jmears63/batgizmo-logger-kicad/horns/exponential-horn-block-2.stl

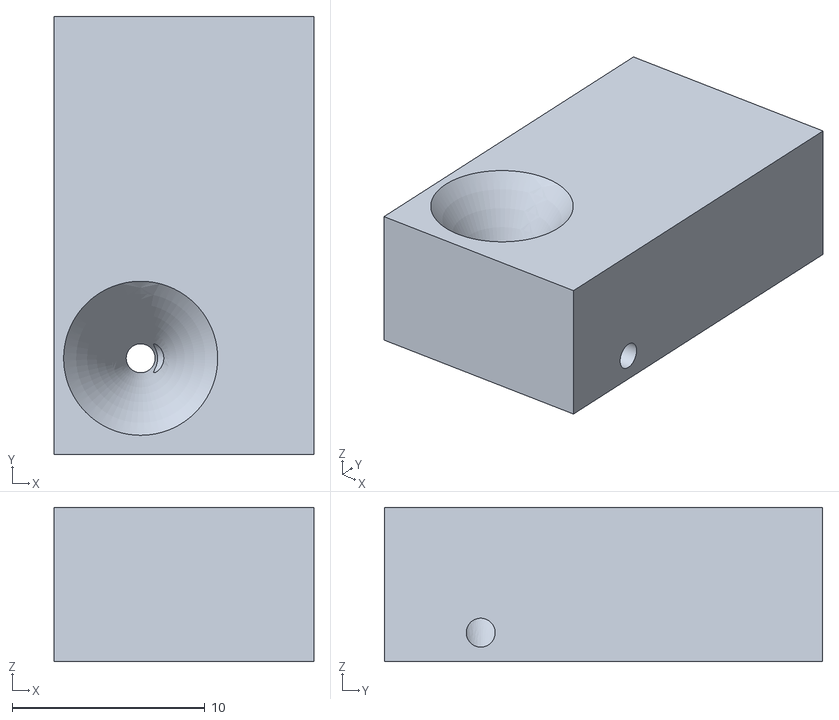
[picture p4: CAD file, 2026-05-30]
horns/exponential-horn-block-2.stl
13.5 x 22.8 x 8.00
