jmears63/batgizmo-logger-kicad/horns/exponential-audiomoth-adapter.stl

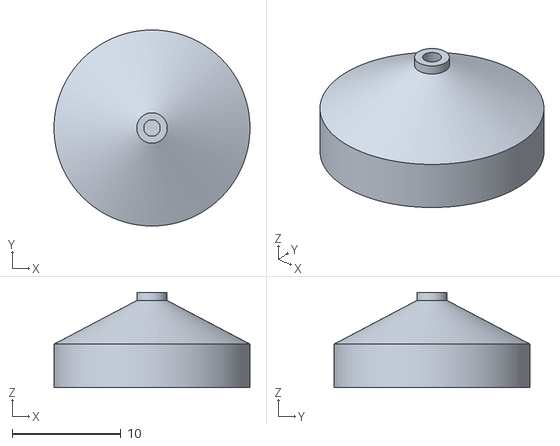
[picture p5: CAD file, 2026-05-30]
horns/exponential-audiomoth-adapter.stl
18.0 x 18.0 x 8.75
