jmears63/batgizmo-logger-kicad/BatGizmo-logger.kicad_pcb

## KiCad design BatGizmo-logger.kicad_pcb (2026-03-31)

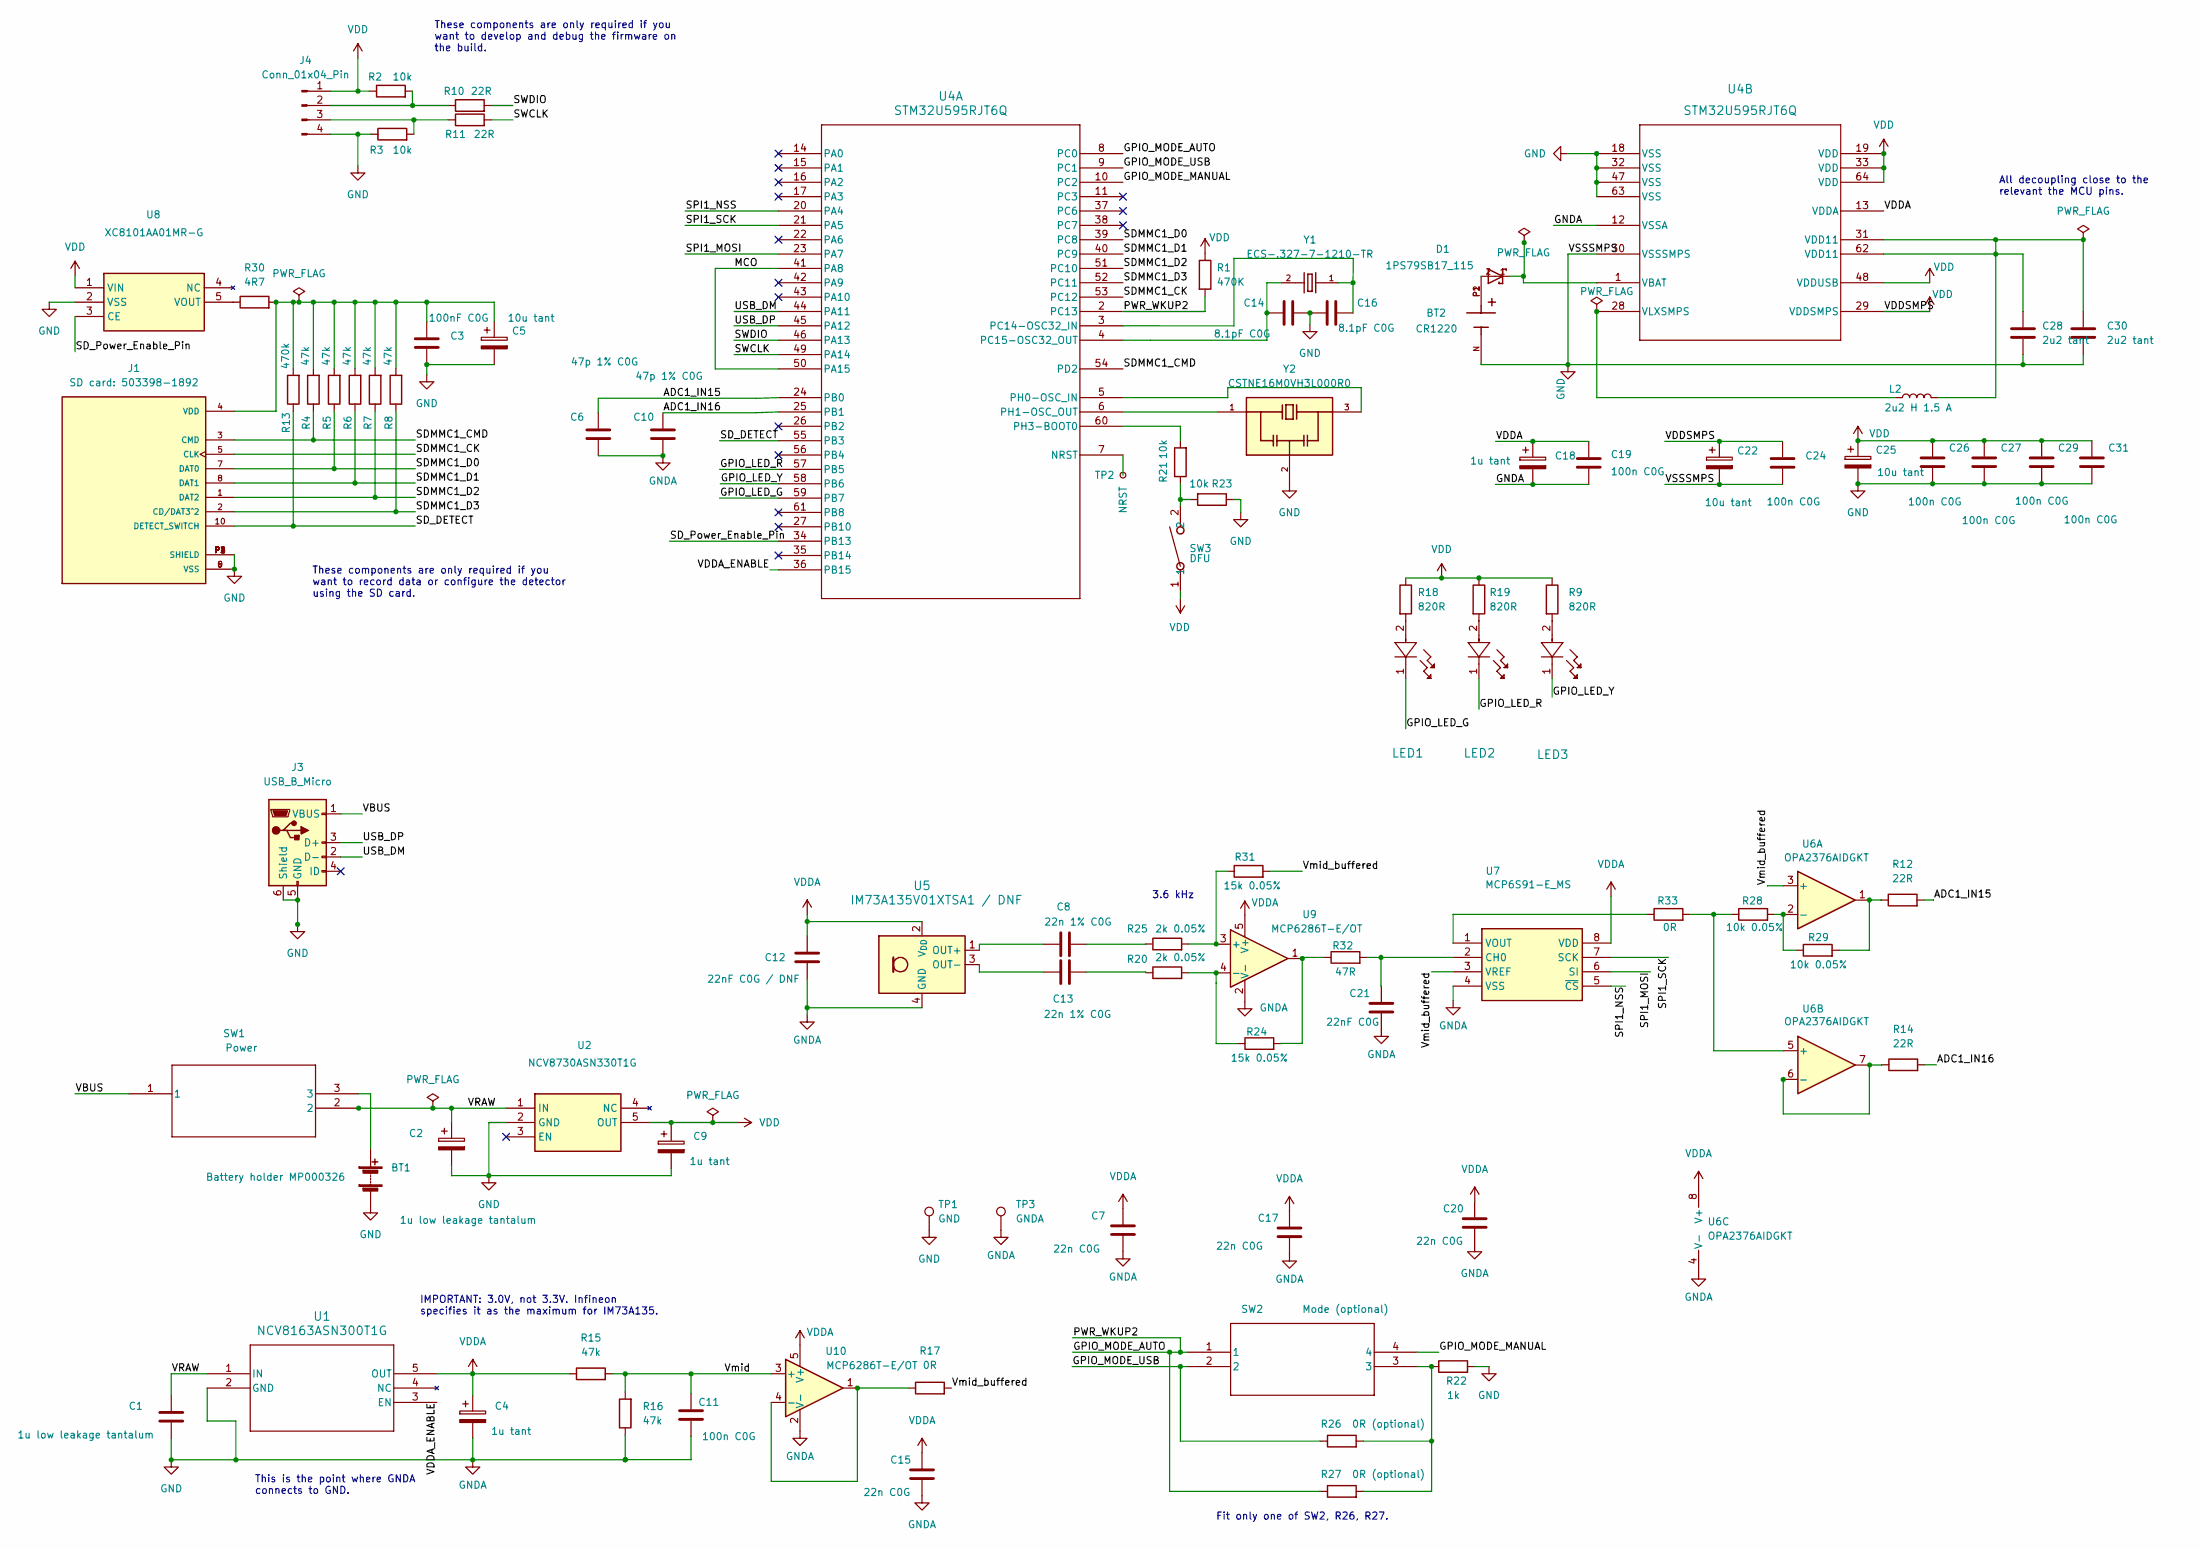
[picture p6: schematic BatGizmo-logger.kicad_sch, BatGizmo Logger]

Parts:
BT1: Battery holder MP000326; MP000326 battery holder
BT2: CR1220; BAT_3000; PARTREV M
C1: 1u low leakage tantalum; C_0805_2012Metric_Pad1.18x1.45mm_HandSolder; Farnell Part Number 2773210
C2: 1u low leakage tantalum; CP_EIA-2012-12_Kemet-R; Farnell Part Number 2773210
C3: 100nF C0G; C_1206_3216Metric_Pad1.33x1.80mm_HandSolder
C4, C9, C18: 1u tant; CP_EIA-2012-12_Kemet-R
C5, C22, C25: 10u tant; CP_EIA-2012-12_Kemet-R
C6, C10: 47p 1% C0G; C_0805_2012Metric_Pad1.18x1.45mm_HandSolder
C7, C15, C17, C20: 22n C0G; C_0805_2012Metric_Pad1.18x1.45mm_HandSolder
C8, C13: 22n 1% C0G; C_0805_2012Metric_Pad1.18x1.45mm_HandSolder
C11, C19, C24, C26, C27, C29, C31: 100n C0G; C_1206_3216Metric_Pad1.33x1.80mm_HandSolder
C12: 22nF C0G / DNF; C_0805_2012Metric_Pad1.18x1.45mm_HandSolder
C14, C16: 8.1pF C0G; C_0805_2012Metric_Pad1.18x1.45mm_HandSolder
C21: 22nF C0G; C_0805_2012Metric_Pad1.18x1.45mm_HandSolder
C28, C30: 2u2 tant; C_0805_2012Metric_Pad1.18x1.45mm_HandSolder
D1: 1PS79SB17_115; SOD523
J1: SD card: 503398-1892; MOLEX_503398-1892; PARTREV 0
J3: USB_B_Micro; USB_Micro-B_Molex_47346-0001
J4: Conn_01x04_Pin; PinHeader_1x04_P2.54mm_Vertical
L2: 2u2 H 1.5 A; INDC2016X120N; Manufacturer_Part_Number MURATA 1286AS-H-2R2M=P2; Farnell Part Number 2530046
LED1: 597-6301-607F; LED_1206_3216Metric_ReverseMount
LED2: 597-6001-607F; LED_1206_3216Metric_ReverseMount
LED3: 597-6201-607F; LED_1206_3216Metric_ReverseMount
R1: 470K; R_0805_2012Metric_Pad1.20x1.40mm_HandSolder
R2, R3, R21, R23: 10k; R_0805_2012Metric_Pad1.20x1.40mm_HandSolder
R4, R5, R6, R7, R8, R15, R16: 47k; R_0805_2012Metric_Pad1.20x1.40mm_HandSolder
R9, R18, R19: 820R; R_0805_2012Metric_Pad1.20x1.40mm_HandSolder
R10, R11, R12, R14: 22R; R_0805_2012Metric_Pad1.20x1.40mm_HandSolder
R13: 470k; R_0805_2012Metric_Pad1.20x1.40mm_HandSolder
R17, R33: 0R; R_0805_2012Metric_Pad1.20x1.40mm_HandSolder
R20, R25: 2k 0.05%; R_0805_2012Metric_Pad1.20x1.40mm_HandSolder
R22: 1k; R_0805_2012Metric_Pad1.20x1.40mm_HandSolder
R24, R31: 15k 0.05%; R_0805_2012Metric_Pad1.20x1.40mm_HandSolder
R26, R27: 0R (optional); R_0805_2012Metric_Pad1.20x1.40mm_HandSolder
R28, R29: 10k 0.05%; R_0805_2012Metric_Pad1.20x1.40mm_HandSolder
R30: 4R7; R_0805_2012Metric_Pad1.20x1.40mm_HandSolder
R32: 47R; R_0805_2012Metric_Pad1.20x1.40mm_HandSolder
SW1: Power; SW_SPDT_PCM12; Manufacturer_Part_Number C&K COMPONENTS PCM12SMTR; Farnell Part Number 9575146
SW2: Mode (optional); SW_SP3T_PCM13; Manufacturer_Part_Number C&K COMPONENTS PCM13SMTR; Farnell Part Number 2320077
SW3: DFU; SW_EVQPUJ_4P7X3P5_PAN; Manufacturer_Part_Number PANASONIC EVQPUJ02K; Farnell Part Number 2860923
TP1: GND; TestPoint_Keystone_5019_Minature
TP2: NRST; TestPoint_Pad_1.0x1.0mm
TP3: GNDA; TestPoint_Keystone_5019_Minature
U1: NCV8163ASN300T1G; SOT95P275X110-5N; Farnell Part Number 2981200
U2: NCV8730ASN330T1G; SOT95P275X110-5N; Manufacturer_Part_Number NCV8730ASN330T1G; Mouser Part Number 863-NCV8730ASN330T1G
U4: STM32U595RJT6Q; LQFP64-10x10mm_STM; Farnell Part Number 4228009
U5: IM73A135V01XTSA1 / DNF; Infineon_PG-LLGA-5-2
U6: OPA2376AIDGKT; SOP65P488X118-8N
U7: MCP6S91-E_MS; SOP65P488X118-8N; Manufacturer_Part_Number MCP6S91-E/MS; Mouser Part Number 579-MCP6S91-E/MS
U8: XC8101AA01MR-G; SOT95P280X130-5N; Manufacturer_Part_Number XC8101AA01MR-G; Mouser Part Number 865-XC8101AA01MR-G
U9, U10: MCP6286T-E/OT; SOT-23-5
Y1: ECS-.327-7-1210-TR; XTAL_ECS-.327-7-1210-TR; Farnell Part Number 3649639
Y2: CSTNE16M0VH3L000R0; Resonator_SMD_Murata_CSTxExxV-3Pin_3.0x1.1mm; PARTREV JGC42-8853B; Farnell Part Number 4127639

Connections:
/ADC1_IN15: C6.1, R12.2, U4.24 (PB0)
/ADC1_IN16: C10.1, R14.2, U4.25 (PB1)
/GPIO_LED_G: LED1.1, U4.59 (PB7)
/GPIO_LED_R: LED2.1, U4.57 (PB5)
/GPIO_LED_Y: LED3.1, U4.58 (PB6)
/GPIO_MODE_AUTO: R1.2, R27.1, SW2.1, U4.2 (PC13), U4.8 (PC0)
/GPIO_MODE_MANUAL: SW2.4, U4.10 (PC2)
/GPIO_MODE_USB: R26.1, SW2.2, U4.9 (PC1)
/MCO: U4.41 (PA8), U4.50 (PA15)
/SDMMC1_CK: J1.5 (CLK), U4.53 (PC12)
/SDMMC1_CMD: J1.3 (CMD), R4.1, U4.54 (PD2)
/SDMMC1_D0: J1.7 (DAT0), R5.1, U4.39 (PC8)
/SDMMC1_D1: J1.8 (DAT1), R6.1, U4.40 (PC9)
/SDMMC1_D2: J1.1 (DAT2), R7.1, U4.51 (PC10)
/SDMMC1_D3: J1.2 (CD/DAT3^2), R8.1, U4.52 (PC11)
/SD_DETECT: J1.10 (DETECT_SWITCH), R13.1, U4.55 (PB3)
/SD_Power_Enable_Pin: U4.34 (PB13), U8.3 (CE)
/SPI1_MOSI: U4.23 (PA7), U7.6 (SI)
/SPI1_NSS: U4.20 (PA4), U7.5 (~CS)
/SPI1_SCK: U4.21 (PA5), U7.7 (SCK)
/SWCLK: R11.2, U4.49 (PA14)
/SWDIO: R10.2, U4.46 (PA13)
/USB_DM: J3.2 (D-), U4.44 (PA11)
/USB_DP: J3.3 (D+), U4.45 (PA12)
/VBUS: J3.1 (VBUS), SW1.1
/VDDA_ENABLE: U1.3 (EN), U4.36 (PB15)
/VRAW: C1.1, C2.1, SW1.2, U1.1 (IN), U2.1 (IN)
/Vmid: C11.1, R15.2, R16.2, U10.3 (+)
/Vmid_buffered: R17.2, R31.2, U6.3 (+), U7.3 (VREF)
GND: BT1.2 (-), BT2.N, C1.2, C2.2, C3.2, C4.2, C5.2, C6.2, C7.2, C9.2, C10.2, C11.2, C12.2, C14.2, C15.2, C16.1, C17.2, C18.2, C19.2, C20.2, C21.1, C22.2, C24.2, C25.2, C26.2, C27.2, C28.2, C29.2, C30.2, C31.2, J1.6 (VSS), J1.9 (VSS), J1.P1 (SHIELD), J1.P2 (SHIELD), J1.P3 (SHIELD), J1.P4 (SHIELD), J3.5 (GND), J3.6 (Shield), J4.4, R3.1, R16.1, R22.2, R23.1, TP1.1, TP3.1, U1.2 (GND), U2.2 (GND), U4.12 (VSSA), U4.18 (VSS), U4.30 (VSSSMPS), U4.32 (VSS), U4.47 (VSS), U4.63 (VSS), U5.4 (GND), U5.5 (GND), U6.4 (V-), U7.4 (VSS), U8.2 (VSS), U9.2 (V-), U10.2 (V-), Y2.2
unnamed: BT1.1 (+), SW1.3
unnamed: BT2.P1, BT2.P2, D1.2
unnamed: C8.2, R25.1
unnamed: C13.2, R20.1
unnamed: C28.1, C30.1, L2.2, U4.31 (VDD11), U4.62 (VDD11)
unnamed: C3.1, C5.1, J1.4 (VDD), R4.2, R5.2, R6.2, R7.2, R8.2, R13.2, R30.2
unnamed: J4.2, R2.2, R10.1
unnamed: J4.3, R3.2, R11.1
unnamed: LED1.2, R18.2
unnamed: LED2.2, R19.2
unnamed: LED3.2, R9.2
unnamed: R12.1, R29.2, U6.1
unnamed: R21.1, R23.2, SW3.2
unnamed: R22.1, R26.2, R27.2, SW2.3
unnamed: R24.2, R32.1, U9.1
unnamed: TP2.1, U4.7 (NRST)
unnamed: C16.2, U4.3 (PC14-OSC32_IN), Y1.1
unnamed: C14.1, U4.4 (PC15-OSC32_OUT), Y1.2
unnamed: U4.5 (PH0-OSC_IN), Y2.3
unnamed: U4.6 (PH1-OSC_OUT), Y2.1
unnamed: R21.2, U4.60 (PH3-BOOT0)
unnamed: D1.1, U4.1 (VBAT)
unnamed: L2.1, U4.28 (VLXSMPS)
unnamed: C8.1, U5.1 (OUT+)
unnamed: C13.1, U5.3 (OUT-)
unnamed: R28.2, R29.1, U6.2 (-)
unnamed: R28.1, R33.2, U6.5 (+)
unnamed: R14.1, U6.6 (-), U6.7
unnamed: C21.2, R32.2, U7.2 (CH0)
unnamed: R33.1, U7.1 (VOUT)
unnamed: R30.1, U8.5 (VOUT)
unnamed: R25.2, R31.1, U9.3 (+)
unnamed: R20.2, R24.1, U9.4 (-)
unnamed: R17.1, U10.1, U10.4 (-)
VDD: C9.1, C22.1, C24.1, C25.1, C26.1, C27.1, C29.1, C31.1, J4.1, R1.1, R2.1, R9.1, R18.1, R19.1, SW3.1, U2.5 (OUT), U4.19 (VDD), U4.29 (VDDSMPS), U4.33 (VDD), U4.48 (VDDUSB), U4.64 (VDD), U8.1 (VIN)
VDDA: C4.1, C7.1, C12.1, C15.1, C17.1, C18.1, C19.1, C20.1, R15.1, U1.5 (OUT), U4.13 (VDDA), U5.2 (V_{DD}), U6.8 (V+), U7.8 (VDD), U9.5 (V+), U10.5 (V+)

Notes on the sheet:
These components are only required if you want to develop and debug the firmware on the build.
All decoupling close to the relevant the MCU pins.
Fit only one of SW2, R26, R27.
3.6 kHz
IMPORTANT: 3.0V, not 3.3V. Infineon specifies it as the maximum for IM73A135.
This is the point where GNDA connects to GND.
These components are only required if you want to record data or configure the detector using the SD card.

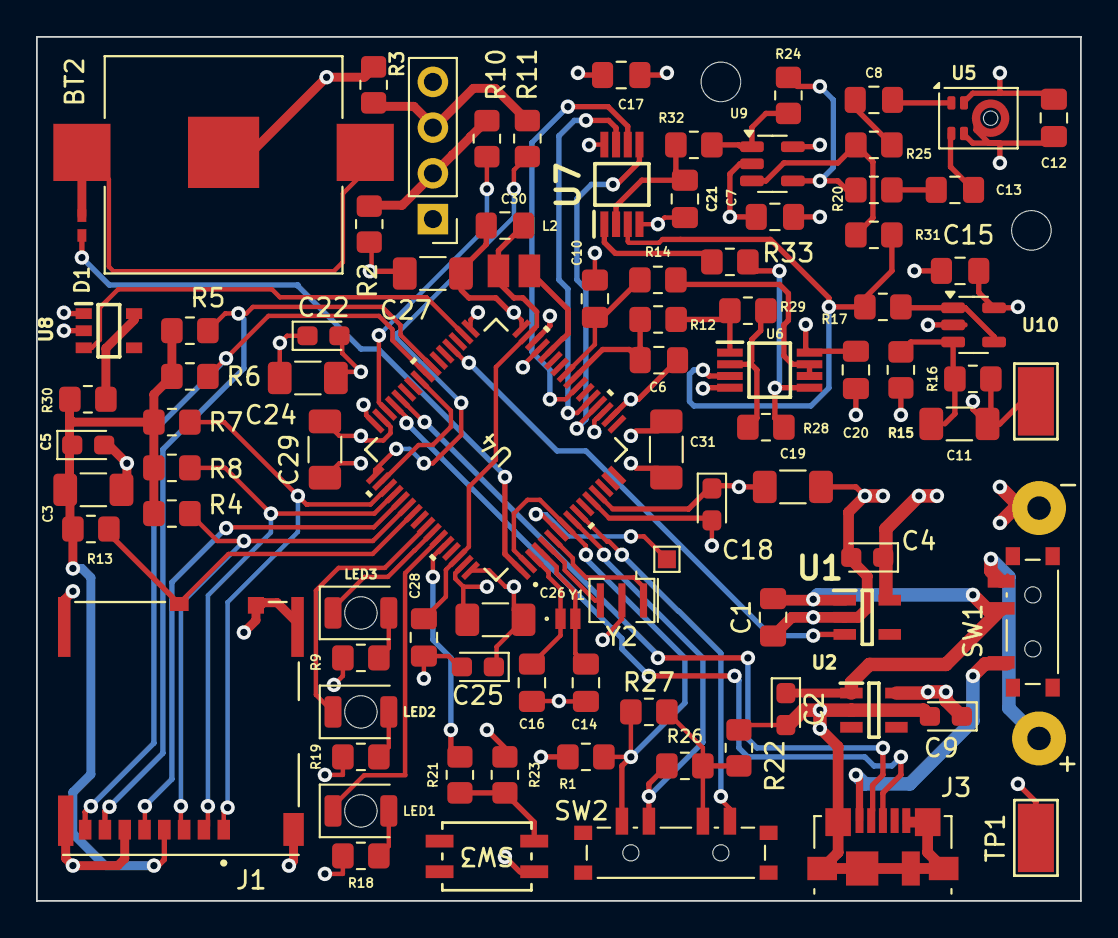
[picture p7: board BatGizmo-logger.kicad_pcb from above]

Board: 4 copper layers, 58.0 x 48.0 mm, 90 parts (0 on the bottom side), 66 nets.
