jmears63/batgizmo-logger-kicad/(commit log)

2026-03-31 Added all project files with copyright and licence.
    [BatGizmo-logger.kicad_pcb, BatGizmo-logger.kicad_sch]
2026-03-31 Updated README.md, including images of the PCB.
2026-03-31 Added an image of the schematic.
2026-05-30 Added source code and .stl files for exponential horns to use with this PCB.
    [exponential-audiomoth-adapter.stl, exponential-horn-block-2.stl]
2026-09-02 upload BOM
    [BOM_batgizmo-logger_Frank_DD4WH_2026_05_20.csv]
