jmears63/batgizmo-logger-kicad/(notices)

Notices in the files:
BatGizmo-logger.kicad_pcb:
(c) Copyright 2023-2025 John Mears
BatGizmo-logger.kicad_sch:
This source describes Open Hardware and is licensed under the
CERN-OHL-P v2.
